fdufnews/USB_cable_tester_V2/hardware/USBAdapter.jpg

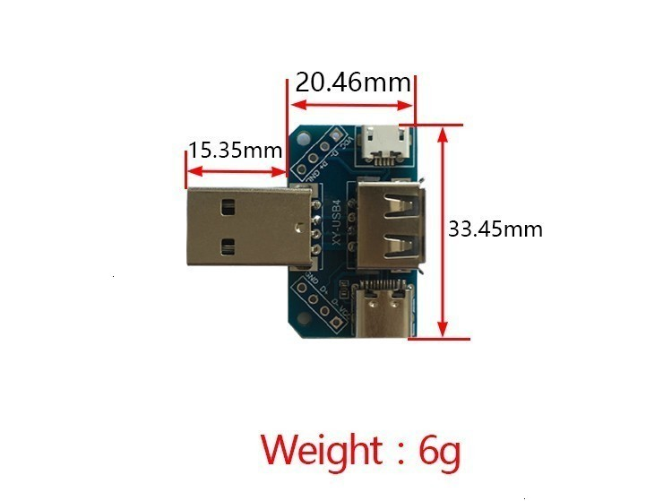
hardware/USBAdapter.jpg
