fdufnews/USB_cable_tester_V2/pictures/IMG_20220719_102000.jpg

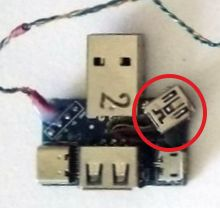
pictures/IMG_20220719_102000.jpg
