fdufnews/USB_cable_tester_V2/hardware/USB_cable_tester.pdf

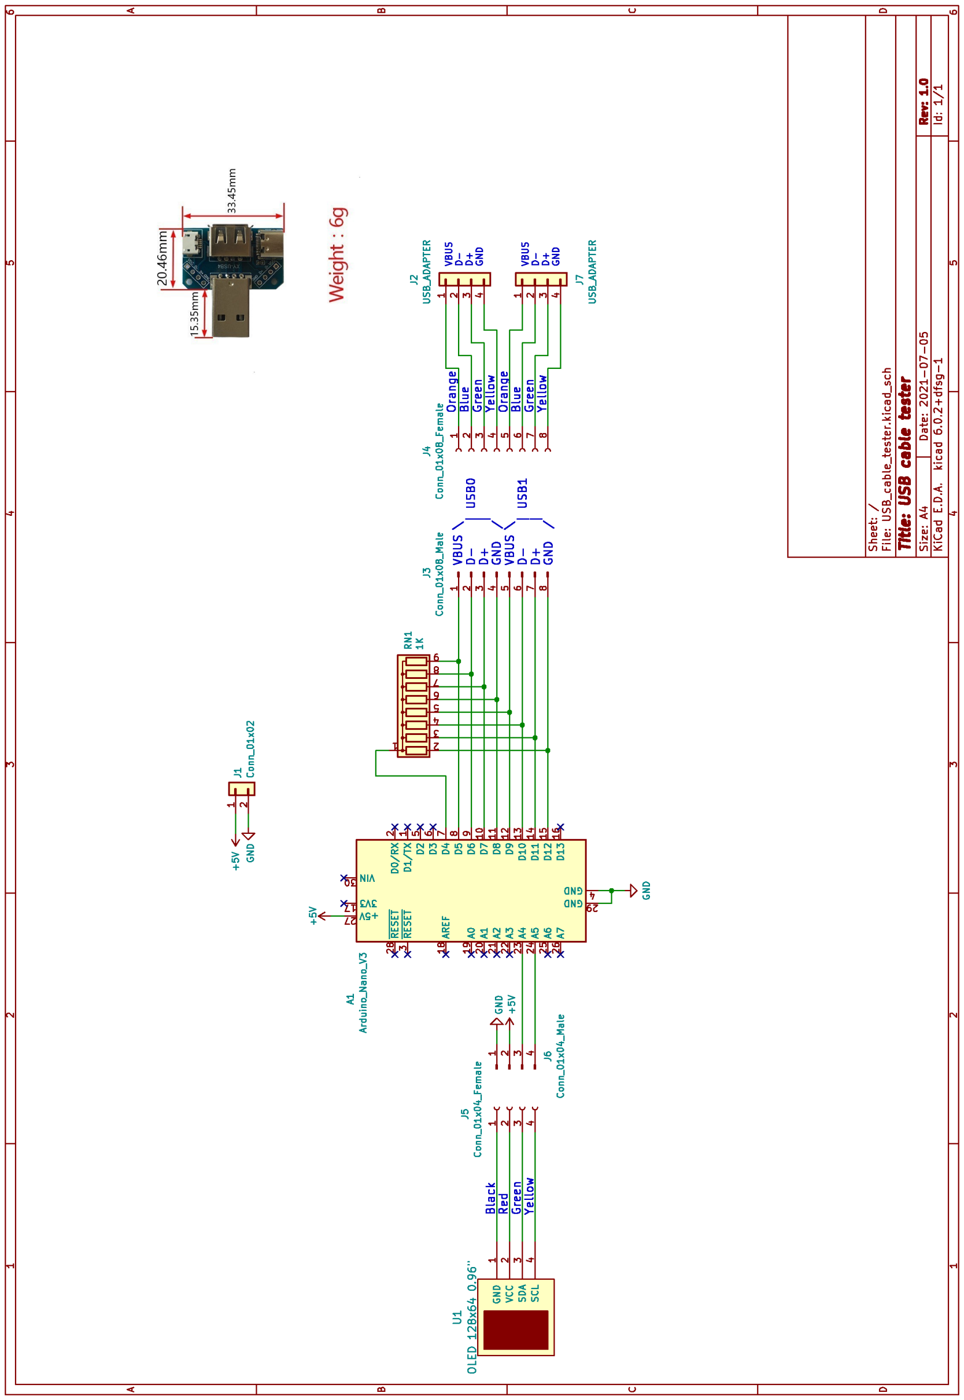
[picture p9: page 1]
