fdufnews/USB_cable_tester_V2/usb-cable.h

#define usbcable_width  128
#define usbcable_height 64

const uint8_t PROGMEM usbcable_data[] = {
  0b00000011,0b11111111,0b11111111,0b11000000,0b00000000,0b00000000,0b00000000,0b00000000,0b00000000,0b00000000,0b00000000,0b00011111,0b11111111,0b11111000,0b00000000,0b00000000,
  0b00000111,0b11111111,0b11111111,0b11100000,0b00000000,0b00000000,0b00000000,0b00000000,0b00000000,0b00000000,0b00000000,0b01111111,0b11111111,0b11111110,0b00000000,0b00000000,
  0b00000111,0b11111111,0b11111111,0b11100000,0b00000000,0b00000000,0b00000000,0b00000000,0b00000000,0b00000000,0b00000000,0b11111111,0b11111111,0b11111111,0b00000000,0b00000000,
  0b00000111,0b11111111,0b11111111,0b11100000,0b00000000,0b00000000,0b00000000,0b00000000,0b00000000,0b00000000,0b00000011,0b11111111,0b11111111,0b11111111,0b10000000,0b00000000,
  0b00000111,0b11111111,0b11111111,0b11100000,0b00000000,0b00000000,0b00000000,0b00000000,0b00000000,0b00000000,0b00000111,0b11111111,0b11111111,0b11111111,0b11000000,0b00000000,
  0b00000111,0b11111111,0b11111111,0b11100000,0b00000000,0b00000000,0b00000000,0b00000000,0b00000000,0b00000000,0b00000111,0b11111111,0b11111111,0b11111111,0b11100000,0b00000000,
  0b00000111,0b11110000,0b00001111,0b11100000,0b00000000,0b00000000,0b00000000,0b00000000,0b00000000,0b00000000,0b00001111,0b11111111,0b00000000,0b11111111,0b11110000,0b00000000,
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
  0b00111111,0b11100000,0b00001111,0b11111100,0b00000000,0b00111111,0b10000000,0b00000000,0b00000000,0b00000000,0b00000000,0b00000000,0b00011111,0b11111111,0b11111111,0b11111111,
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
};
