fdufnews/USB_cable_tester_V2/(commit log)

2022-07-19 Added pictures
    Added picture of the prototype and examples of the different screens
2022-07-19 Added some pictures. Added version number on splashscreen
    Added pictures of prototype
    Added version number in the software and print it on the splashscreen.
2022-07-19 Added notice concerning connected grounds
